maivananh111/PCB_GatewayPlus_V1.4/GatewayPlus_V1.4.kicad_pcb

## KiCad design GatewayPlus_V1.4.kicad_pcb (2023-03-02)

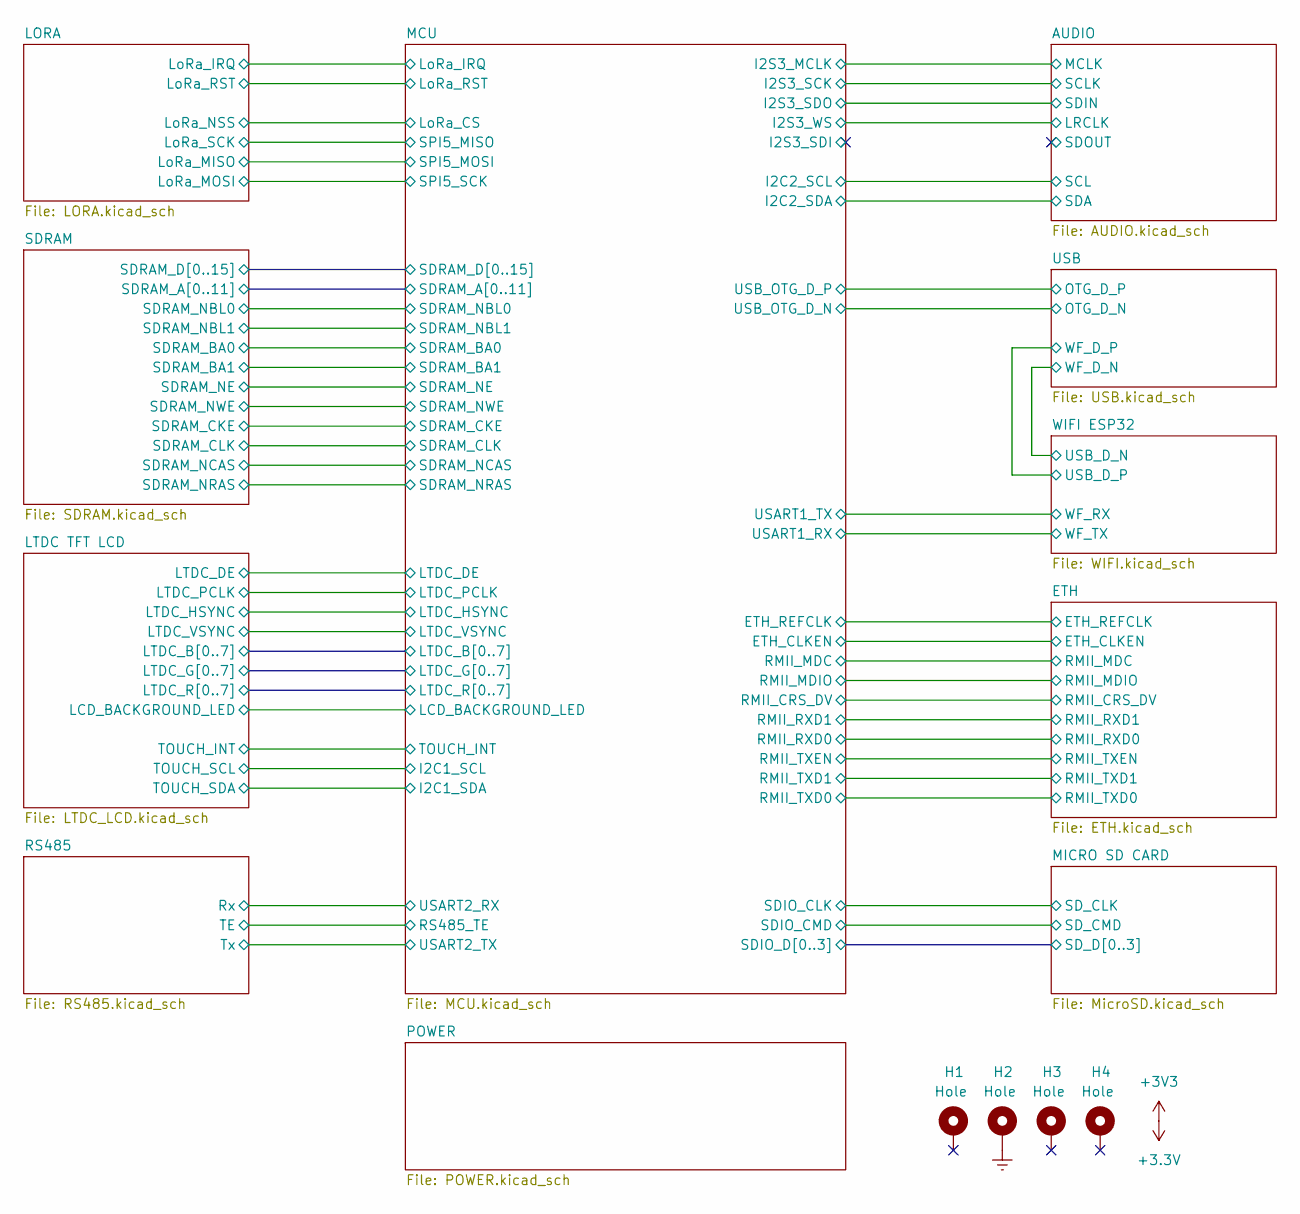
[picture p1: schematic GatewayPlus_V1.4.kicad_sch]

Parts:
H1, H2, H3, H4: Hole; MountingHole_3.2mm_M3_Pad_Via

Connections:
Earth: H2.1; also elsewhere on the board

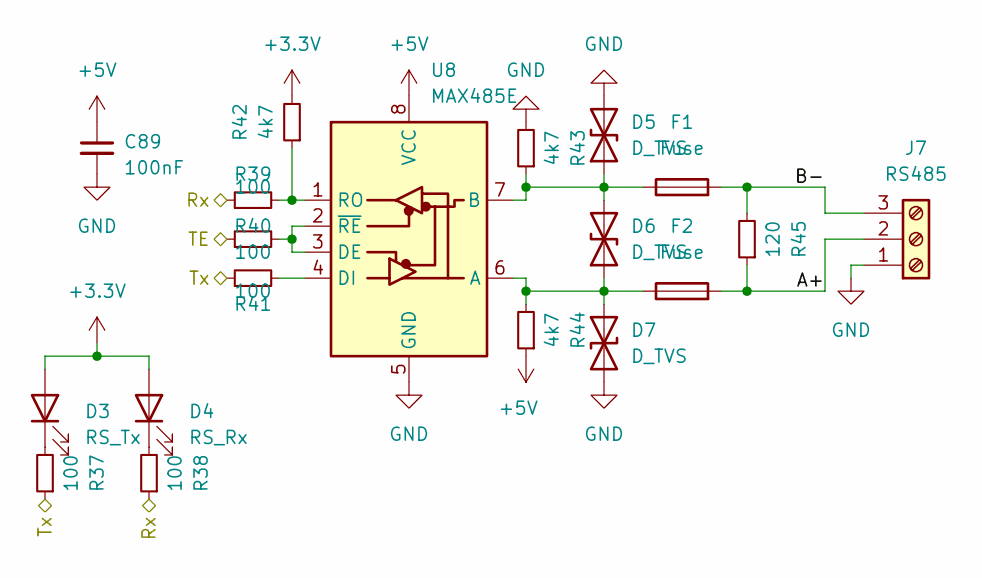
[picture p2: schematic RS485.kicad_sch]

Parts:
C89: 100nF; C_0603
D3: RS_Tx; LED_0603
D4: RS_Rx; LED_0603
D5, D6, D7: D_TVS; D_SMA
F1, F2: Fuse; F_1206
J7: RS485; TerminalBlock_Phoenix_MKDS-1,5-3-5.08_1x03_P5.08mm_Horizont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
R37, R38, R39, R40, R41: 100; R_0603
R42, R43, R44: 4k7; R_0603
R45: 120; R_0805
U8: MAX485E; SOIC-8

Connections:
/MCU/RS485_TE: R40.1; also elsewhere on the board
/MCU/USART2_RX: R38.1, R39.1; also elsewhere on the board
/MCU/USART2_TX: R37.1, R41.1; also elsewhere on the board
/RS485/A+: F2.2, J7.2, R45.1
/RS485/B-: F1.2, J7.3, R45.2
GND: C89.2, D5.2 (A2), D7.2 (A2), J7.1, R43.2, U8.5 (GND); also elsewhere on the board
unnamed: D3.1 (K), R37.2
unnamed: D4.1 (K), R38.2
unnamed: D5.1 (A1), D6.2 (A2), F1.1, R43.1, U8.7 (B)
unnamed: D6.1 (A1), D7.1 (A1), F2.1, R44.2, U8.6 (A)
unnamed: R40.2, U8.2 (~RE), U8.3 (DE)
unnamed: R41.2, U8.4 (DI)
unnamed: R39.2, R42.1, U8.1 (RO)

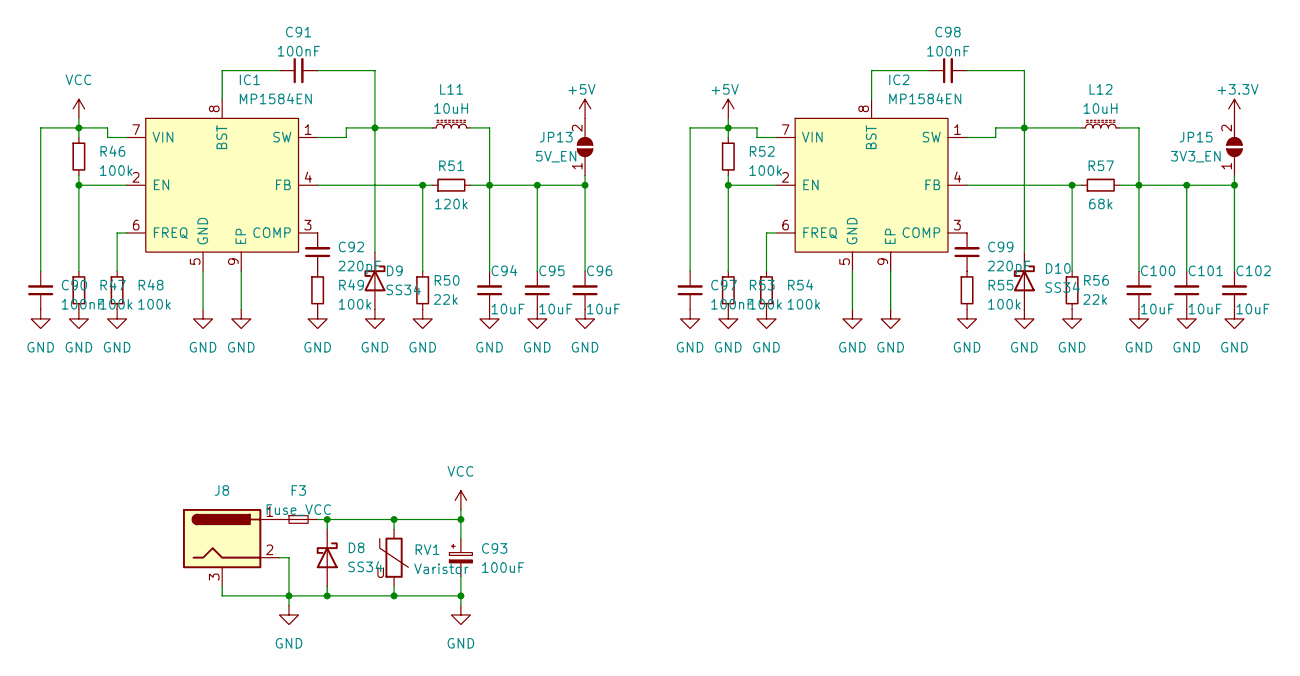
[picture p3: schematic POWER.kicad_sch]

Parts:
C90, C91, C97, C98: 100nF; C_0603
C92, C99: 220pF; C_0603
C93: 100uF; CP_Elec_6.3x5.4
C94, C95, C96, C100, C101, C102: 10uF; C_1210
D8, D9, D10: SS34; D_SMA
F3: Fuse_VCC; F_1206
IC1, IC2: MP1584EN; SOIC-8_PAD_VIAS
J8: Conn_Jack-DC; DC_PowerJack_5mm_THT
JP13: 5V_EN; SolderJumper-2_P1.3mm_Open_RoundedPad1.0x1.5mm
JP15: 3V3_EN; SolderJumper-2_P1.3mm_Open_RoundedPad1.0x1.5mm
L11, L12: 10uH; L_Abracon_ASPI-0630LR
R46, R47, R48, R49, R52, R53, R54, R55: 100k; R_0603
R50, R56: 22k; R_0603
R51: 120k; R_0603
R57: 68k; R_0603
RV1: Varistor; RV_Disc_D9mm_W3.3mm_P5mm

Connections:
GND: C90.1, C93.2, C94.1, C95.1, C96.1, C97.1, C100.1, C101.1, C102.1, D8.2 (A), D9.2 (A), D10.2 (A), IC1.5 (GND), IC1.9 (EP), IC2.5 (GND), IC2.9 (EP), J8.2, J8.3, R47.2, R48.2, R49.2, R50.2, R53.2, R54.2, R55.2, R56.2, RV1.2; also elsewhere on the board
unnamed: C92.1, R49.1
unnamed: C99.1, R55.1
unnamed: C91.2, D9.1 (K), IC1.1 (SW), L11.1
unnamed: C98.2, D10.1 (K), IC2.1 (SW), L12.1
unnamed: F3.1, J8.1
unnamed: C91.1, IC1.8 (BST)
unnamed: C92.2, IC1.3 (COMP)
unnamed: IC1.2 (EN), R46.2, R47.1
unnamed: IC1.4 (FB), R50.1, R51.1
unnamed: IC1.6 (FREQ), R48.1
unnamed: C98.1, IC2.8 (BST)
unnamed: C99.2, IC2.3 (COMP)
unnamed: IC2.2 (EN), R52.2, R53.1
unnamed: IC2.4 (FB), R56.1, R57.1
unnamed: IC2.6 (FREQ), R54.1
unnamed: C94.2, C95.2, C96.2, JP13.1 (A), L11.2, R51.2
unnamed: C100.2, C101.2, C102.2, JP15.1 (A), L12.2, R57.2
VCC: C90.2, C93.1, D8.1 (K), F3.2, IC1.7 (VIN), R46.1, RV1.1

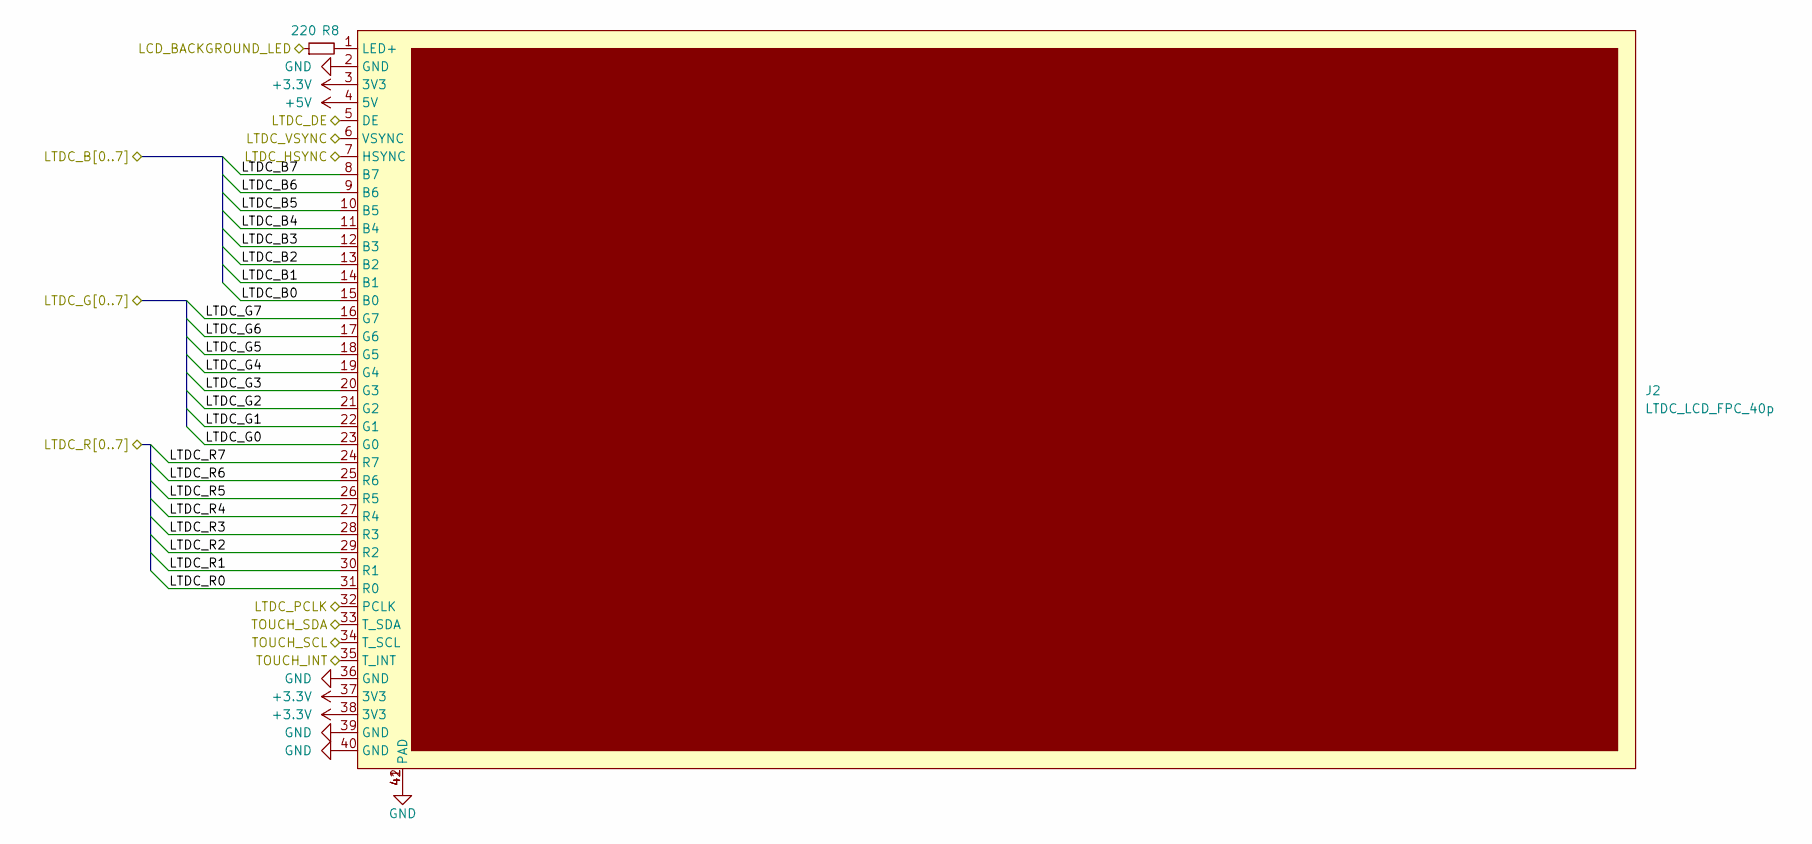
[picture p4: schematic LTDC_LCD.kicad_sch]

Parts:
J2: LTDC_LCD_FPC_40p; FPC_40p_Vertical
R8: 220; R_0603

Connections:
/LTDC TFT LCD/LCD_BACKGROUND_LED: R8.1; also elsewhere on the board
/LTDC TFT LCD/LTDC_B0: J2.15 (B0); also elsewhere on the board
/LTDC TFT LCD/LTDC_B1: J2.14 (B1); also elsewhere on the board
/LTDC TFT LCD/LTDC_B2: J2.13 (B2); also elsewhere on the board
/LTDC TFT LCD/LTDC_B3: J2.12 (B3); also elsewhere on the board
/LTDC TFT LCD/LTDC_B4: J2.11 (B4); also elsewhere on the board
/LTDC TFT LCD/LTDC_B5: J2.10 (B5); also elsewhere on the board
/LTDC TFT LCD/LTDC_B6: J2.9 (B6); also elsewhere on the board
/LTDC TFT LCD/LTDC_B7: J2.8 (B7); also elsewhere on the board
/LTDC TFT LCD/LTDC_DE: J2.5 (DE); also elsewhere on the board
/LTDC TFT LCD/LTDC_G0: J2.23 (G0); also elsewhere on the board
/LTDC TFT LCD/LTDC_G1: J2.22 (G1); also elsewhere on the board
/LTDC TFT LCD/LTDC_G2: J2.21 (G2); also elsewhere on the board
/LTDC TFT LCD/LTDC_G3: J2.20 (G3); also elsewhere on the board
/LTDC TFT LCD/LTDC_G4: J2.19 (G4); also elsewhere on the board
/LTDC TFT LCD/LTDC_G5: J2.18 (G5); also elsewhere on the board
/LTDC TFT LCD/LTDC_G6: J2.17 (G6); also elsewhere on the board
/LTDC TFT LCD/LTDC_G7: J2.16 (G7); also elsewhere on the board
/LTDC TFT LCD/LTDC_HSYNC: J2.7 (HSYNC); also elsewhere on the board
/LTDC TFT LCD/LTDC_PCLK: J2.32 (PCLK); also elsewhere on the board
/LTDC TFT LCD/LTDC_R0: J2.31 (R0); also elsewhere on the board
/LTDC TFT LCD/LTDC_R1: J2.30 (R1); also elsewhere on the board
/LTDC TFT LCD/LTDC_R2: J2.29 (R2); also elsewhere on the board
/LTDC TFT LCD/LTDC_R3: J2.28 (R3); also elsewhere on the board
/LTDC TFT LCD/LTDC_R4: J2.27 (R4); also elsewhere on the board
/LTDC TFT LCD/LTDC_R5: J2.26 (R5); also elsewhere on the board
/LTDC TFT LCD/LTDC_R6: J2.25 (R6); also elsewhere on the board
/LTDC TFT LCD/LTDC_R7: J2.24 (R7); also elsewhere on the board
/LTDC TFT LCD/LTDC_VSYNC: J2.6 (VSYNC); also elsewhere on the board
/LTDC TFT LCD/TOUCH_INT: J2.35 (T_INT); also elsewhere on the board
/LTDC TFT LCD/TOUCH_SCL: J2.34 (T_SCL); also elsewhere on the board
/LTDC TFT LCD/TOUCH_SDA: J2.33 (T_SDA); also elsewhere on the board
GND: J2.2 (GND), J2.36 (GND), J2.39 (GND), J2.40 (GND), J2.41 (PAD), J2.42 (PAD); also elsewhere on the board
unnamed: J2.1 (LED+), R8.2

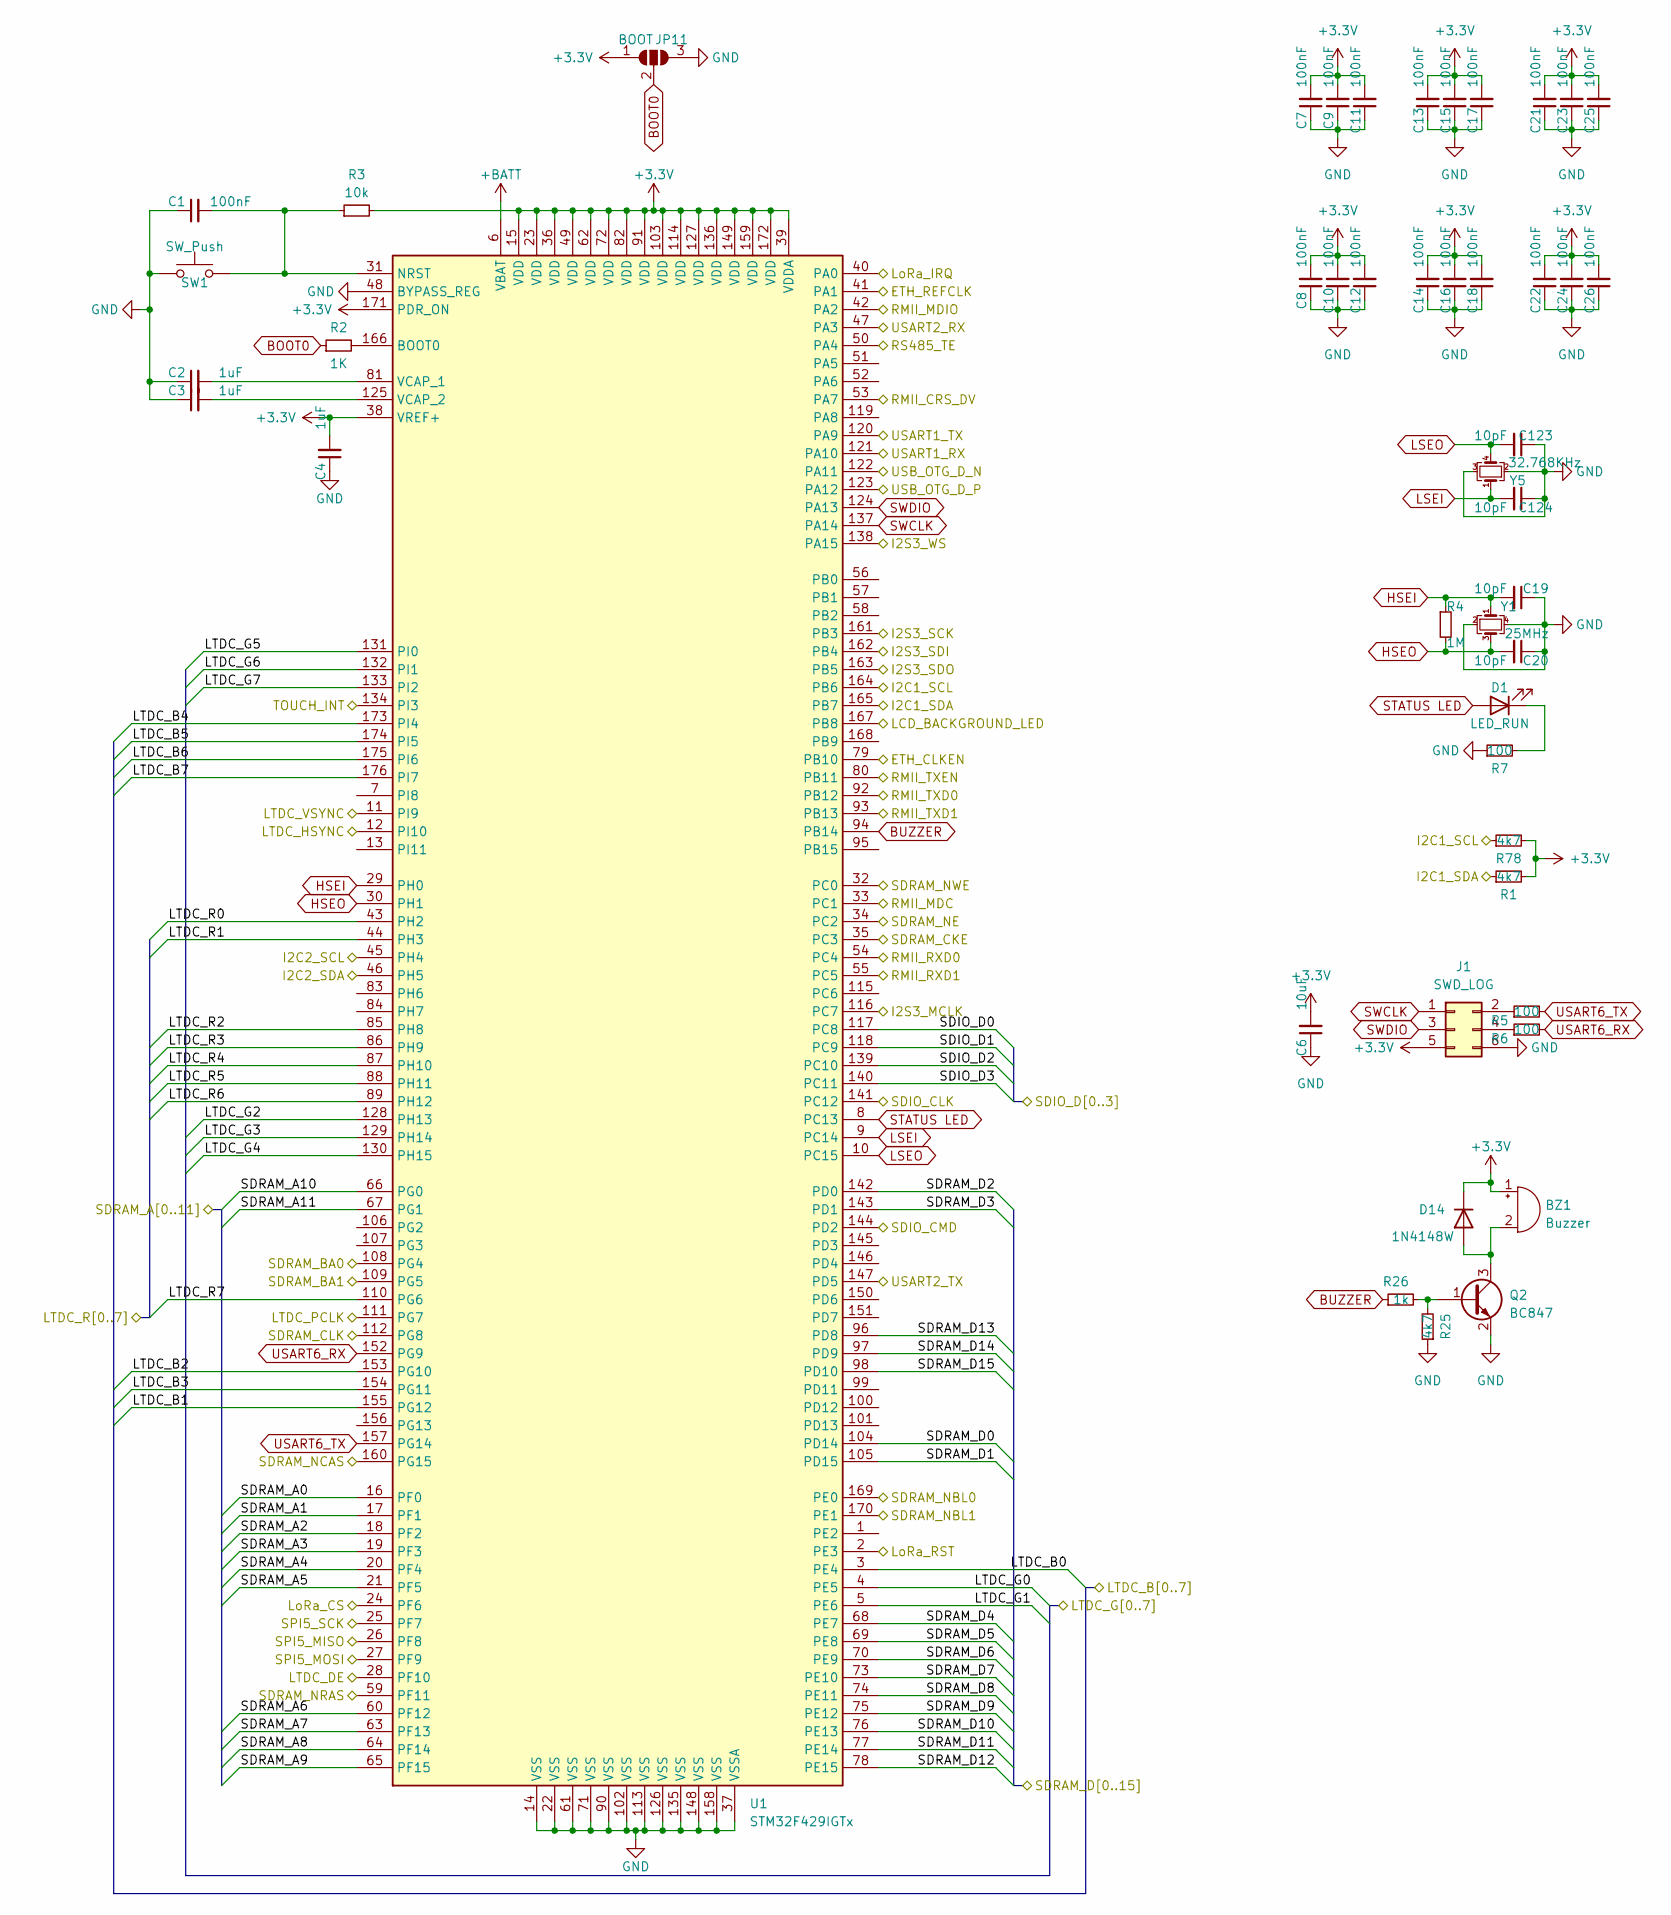
[picture p5: schematic MCU.kicad_sch]

Parts:
BZ1: Buzzer; MagneticBuzzer_ProSignal_ABT-410-RC
C1, C7, C8, C9, C10, C11, C12, C13, C14, C15, C16, C17, C18, C21, C22, C23, C24, C25, C26: 100nF; C_0603
C2, C3, C4: 1uF; C_0603
C6: 10uF; C_1206
C19, C20, C123, C124: 10pF; C_0603
D1: LED_RUN; LED_0603
D14: 1N4148W; D_SOD-123F
J1: SWD_LOG; PinHeader_2x03_P2.54mm_Horizontal
JP11: BOOT; Jump3_0603_Open
Q2: BC847; SOT23-3
R1, R25, R78: 4k7; R_0603
R2: 1K; R_0603
R3: 10k; R_0603
R4: 1M; R_0603
R5, R6, R7: 100; R_0603
R26: 1k; R_0603
SW1: SW_Push; SW_SPST_CK_RS282G05A3
U1: STM32F429IGTx; LQFP-176_24x24
Y1: 25MHz; Crystal_SMD_3225-4Pin_3.2x2.5mm
Y5: 32.768KHz; MC306327680KE3ROHS

Connections:
+BATT: U1.6 (VBAT)
/AUDIO/LRCLK: U1.138 (PA15); also elsewhere on the board
/AUDIO/MCLK: U1.116 (PC7); also elsewhere on the board
/AUDIO/SCL: U1.45 (PH4); also elsewhere on the board
/AUDIO/SCLK: U1.161 (PB3); also elsewhere on the board
/AUDIO/SDA: U1.46 (PH5); also elsewhere on the board
/AUDIO/SDIN: U1.163 (PB5); also elsewhere on the board
/ETH/ETH_REFCLK: U1.41 (PA1); also elsewhere on the board
/ETH/RMII_CRS_DV: U1.53 (PA7); also elsewhere on the board
/ETH/RMII_MDC: U1.33 (PC1); also elsewhere on the board
/ETH/RMII_MDIO: U1.42 (PA2); also elsewhere on the board
/ETH/RMII_RXD0: U1.54 (PC4); also elsewhere on the board
/ETH/RMII_RXD1: U1.55 (PC5); also elsewhere on the board
/ETH/RMII_TXD0: U1.92 (PB12); also elsewhere on the board
/ETH/RMII_TXD1: U1.93 (PB13); also elsewhere on the board
/ETH/RMII_TXEN: U1.80 (PB11); also elsewhere on the board
/LORA/LoRa_IRQ: U1.40 (PA0); also elsewhere on the board
/LORA/LoRa_MISO: U1.27 (PF9); also elsewhere on the board
/LORA/LoRa_MOSI: U1.25 (PF7); also elsewhere on the board
/LORA/LoRa_NSS: U1.24 (PF6); also elsewhere on the board
/LORA/LoRa_RST: U1.2 (PE3); also elsewhere on the board
/LORA/LoRa_SCK: U1.26 (PF8); also elsewhere on the board
/LTDC TFT LCD/LCD_BACKGROUND_LED: U1.167 (PB8); also elsewhere on the board
/LTDC TFT LCD/LTDC_B0: U1.3 (PE4); also elsewhere on the board
/LTDC TFT LCD/LTDC_B1: U1.155 (PG12); also elsewhere on the board
/LTDC TFT LCD/LTDC_B2: U1.153 (PG10); also elsewhere on the board
/LTDC TFT LCD/LTDC_B3: U1.154 (PG11); also elsewhere on the board
/LTDC TFT LCD/LTDC_B4: U1.173 (PI4); also elsewhere on the board
/LTDC TFT LCD/LTDC_B5: U1.174 (PI5); also elsewhere on the board
/LTDC TFT LCD/LTDC_B6: U1.175 (PI6); also elsewhere on the board
/LTDC TFT LCD/LTDC_B7: U1.176 (PI7); also elsewhere on the board
/LTDC TFT LCD/LTDC_DE: U1.28 (PF10); also elsewhere on the board
/LTDC TFT LCD/LTDC_G0: U1.4 (PE5); also elsewhere on the board
/LTDC TFT LCD/LTDC_G1: U1.5 (PE6); also elsewhere on the board
/LTDC TFT LCD/LTDC_G2: U1.128 (PH13); also elsewhere on the board
/LTDC TFT LCD/LTDC_G3: U1.129 (PH14); also elsewhere on the board
/LTDC TFT LCD/LTDC_G4: U1.130 (PH15); also elsewhere on the board
/LTDC TFT LCD/LTDC_G5: U1.131 (PI0); also elsewhere on the board
/LTDC TFT LCD/LTDC_G6: U1.132 (PI1); also elsewhere on the board
/LTDC TFT LCD/LTDC_G7: U1.133 (PI2); also elsewhere on the board
/LTDC TFT LCD/LTDC_HSYNC: U1.12 (PI10); also elsewhere on the board
/LTDC TFT LCD/LTDC_PCLK: U1.111 (PG7); also elsewhere on the board
/LTDC TFT LCD/LTDC_R0: U1.43 (PH2); also elsewhere on the board
/LTDC TFT LCD/LTDC_R1: U1.44 (PH3); also elsewhere on the board
/LTDC TFT LCD/LTDC_R2: U1.85 (PH8); also elsewhere on the board
/LTDC TFT LCD/LTDC_R3: U1.86 (PH9); also elsewhere on the board
/LTDC TFT LCD/LTDC_R4: U1.87 (PH10); also elsewhere on the board
/LTDC TFT LCD/LTDC_R5: U1.88 (PH11); also elsewhere on the board
/LTDC TFT LCD/LTDC_R6: U1.89 (PH12); also elsewhere on the board
/LTDC TFT LCD/LTDC_R7: U1.110 (PG6); also elsewhere on the board
/LTDC TFT LCD/LTDC_VSYNC: U1.11 (PI9); also elsewhere on the board
/LTDC TFT LCD/TOUCH_INT: U1.134 (PI3); also elsewhere on the board
/LTDC TFT LCD/TOUCH_SCL: R78.1, U1.164 (PB6); also elsewhere on the board
/LTDC TFT LCD/TOUCH_SDA: R1.1, U1.165 (PB7); also elsewhere on the board
/MCU/ETH_CLKEN: U1.79 (PB10)
/MCU/I2S3_SDI: U1.162 (PB4)
/MCU/RS485_TE: U1.50 (PA4); also elsewhere on the board
/MCU/SDIO_CLK: U1.141 (PC12); also elsewhere on the board
/MCU/SDIO_CMD: U1.144 (PD2); also elsewhere on the board
/MCU/SDIO_D0: U1.117 (PC8); also elsewhere on the board
/MCU/SDIO_D1: U1.118 (PC9); also elsewhere on the board
/MCU/SDIO_D2: U1.139 (PC10); also elsewhere on the board
/MCU/SDIO_D3: U1.140 (PC11); also elsewhere on the board
/MCU/SDRAM_A0: U1.16 (PF0); also elsewhere on the board
/MCU/SDRAM_A1: U1.17 (PF1); also elsewhere on the board
/MCU/SDRAM_A2: U1.18 (PF2); also elsewhere on the board
/MCU/SDRAM_A3: U1.19 (PF3); also elsewhere on the board
/MCU/SDRAM_A4: U1.20 (PF4); also elsewhere on the board
/MCU/SDRAM_A5: U1.21 (PF5); also elsewhere on the board
/MCU/SDRAM_A6: U1.60 (PF12); also elsewhere on the board
/MCU/SDRAM_A7: U1.63 (PF13); also elsewhere on the board
/MCU/SDRAM_A8: U1.64 (PF14); also elsewhere on the board
/MCU/SDRAM_A9: U1.65 (PF15); also elsewhere on the board
/MCU/SDRAM_A10: U1.66 (PG0); also elsewhere on the board
/MCU/SDRAM_A11: U1.67 (PG1); also elsewhere on the board
/MCU/SDRAM_BA0: U1.108 (PG4); also elsewhere on the board
/MCU/SDRAM_BA1: U1.109 (PG5); also elsewhere on the board
/MCU/SDRAM_CKE: U1.35 (PC3); also elsewhere on the board
/MCU/SDRAM_CLK: U1.112 (PG8); also elsewhere on the board
/MCU/SDRAM_D0: U1.104 (PD14); also elsewhere on the board
/MCU/SDRAM_D1: U1.105 (PD15); also elsewhere on the board
/MCU/SDRAM_D2: U1.142 (PD0); also elsewhere on the board
/MCU/SDRAM_D3: U1.143 (PD1); also elsewhere on the board
/MCU/SDRAM_D4: U1.68 (PE7); also elsewhere on the board
/MCU/SDRAM_D5: U1.69 (PE8); also elsewhere on the board
/MCU/SDRAM_D6: U1.70 (PE9); also elsewhere on the board
/MCU/SDRAM_D7: U1.73 (PE10); also elsewhere on the board
/MCU/SDRAM_D8: U1.74 (PE11); also elsewhere on the board
/MCU/SDRAM_D9: U1.75 (PE12); also elsewhere on the board
/MCU/SDRAM_D10: U1.76 (PE13); also elsewhere on the board
/MCU/SDRAM_D11: U1.77 (PE14); also elsewhere on the board
/MCU/SDRAM_D12: U1.78 (PE15); also elsewhere on the board
/MCU/SDRAM_D13: U1.96 (PD8); also elsewhere on the board
/MCU/SDRAM_D14: U1.97 (PD9); also elsewhere on the board
/MCU/SDRAM_D15: U1.98 (PD10); also elsewhere on the board
/MCU/SDRAM_NBL0: U1.169 (PE0); also elsewhere on the board
/MCU/SDRAM_NBL1: U1.170 (PE1); also elsewhere on the board
/MCU/SDRAM_NCAS: U1.160 (PG15); also elsewhere on the board
/MCU/SDRAM_NE: U1.34 (PC2); also elsewhere on the board
/MCU/SDRAM_NRAS: U1.59 (PF11); also elsewhere on the board
/MCU/SDRAM_NWE: U1.32 (PC0); also elsewhere on the board
/MCU/USART1_RX: U1.121 (PA10); also elsewhere on the board
/MCU/USART1_TX: U1.120 (PA9); also elsewhere on the board
/MCU/USART2_RX: U1.47 (PA3); also elsewhere on the board
/MCU/USART2_TX: U1.147 (PD5); also elsewhere on the board
/MCU/USB_OTG_D_N: U1.122 (PA11); also elsewhere on the board
/MCU/USB_OTG_D_P: U1.123 (PA12); also elsewhere on the board
BOOT0: JP11.2 (C), R2.1
BUZZER: R26.1, U1.94 (PB14)
GND: C1.1, C2.1, C3.1, C4.1, C6.1, C7.1, C8.1, C9.1, C10.1, C11.1, C12.1, C13.1, C14.1, C15.1, C16.1, C17.1, C18.1, C19.1, C20.1, C21.1, C22.1, C23.1, C24.1, C25.1, C26.1, C123.1, C124.1, J1.6, JP11.3 (B), Q2.2 (E), R7.1, R25.1, SW1.1, U1.14 (VSS), U1.22 (VSS), U1.37 (VSSA), U1.48 (BYPASS_REG), U1.61 (VSS), U1.71 (VSS), U1.90 (VSS), U1.102 (VSS), U1.113 (VSS), U1.126 (VSS), U1.135 (VSS), U1.148 (VSS), U1.158 (VSS), Y1.2, Y1.4, Y5.2, Y5.3; also elsewhere on the board
HSEI: C19.2, R4.1, U1.29 (PH0), Y1.1
HSEO: C20.2, R4.2, U1.30 (PH1), Y1.3
LSEI: C124.2, U1.9 (PC14), Y5.1
LSEO: C123.2, U1.10 (PC15), Y5.4
unnamed: BZ1.2 (+), D14.2 (A), Q2.3 (C)
unnamed: D1.1 (K), R7.2
unnamed: J1.2, R5.1
unnamed: J1.4, R6.1
unnamed: Q2.1 (B), R25.2, R26.2
unnamed: R2.2, U1.166 (BOOT0)
unnamed: C1.2, R3.1, SW1.2, U1.31 (NRST)
unnamed: C2.2, U1.81 (VCAP_1)
unnamed: C3.2, U1.125 (VCAP_2)
STATUS LED: D1.2 (A), U1.8 (PC13)
SWCLK: J1.1, U1.137 (PA14)
SWDIO: J1.3, U1.124 (PA13)
USART6_RX: R6.2, U1.152 (PG9)
USART6_TX: R5.2, U1.157 (PG14)

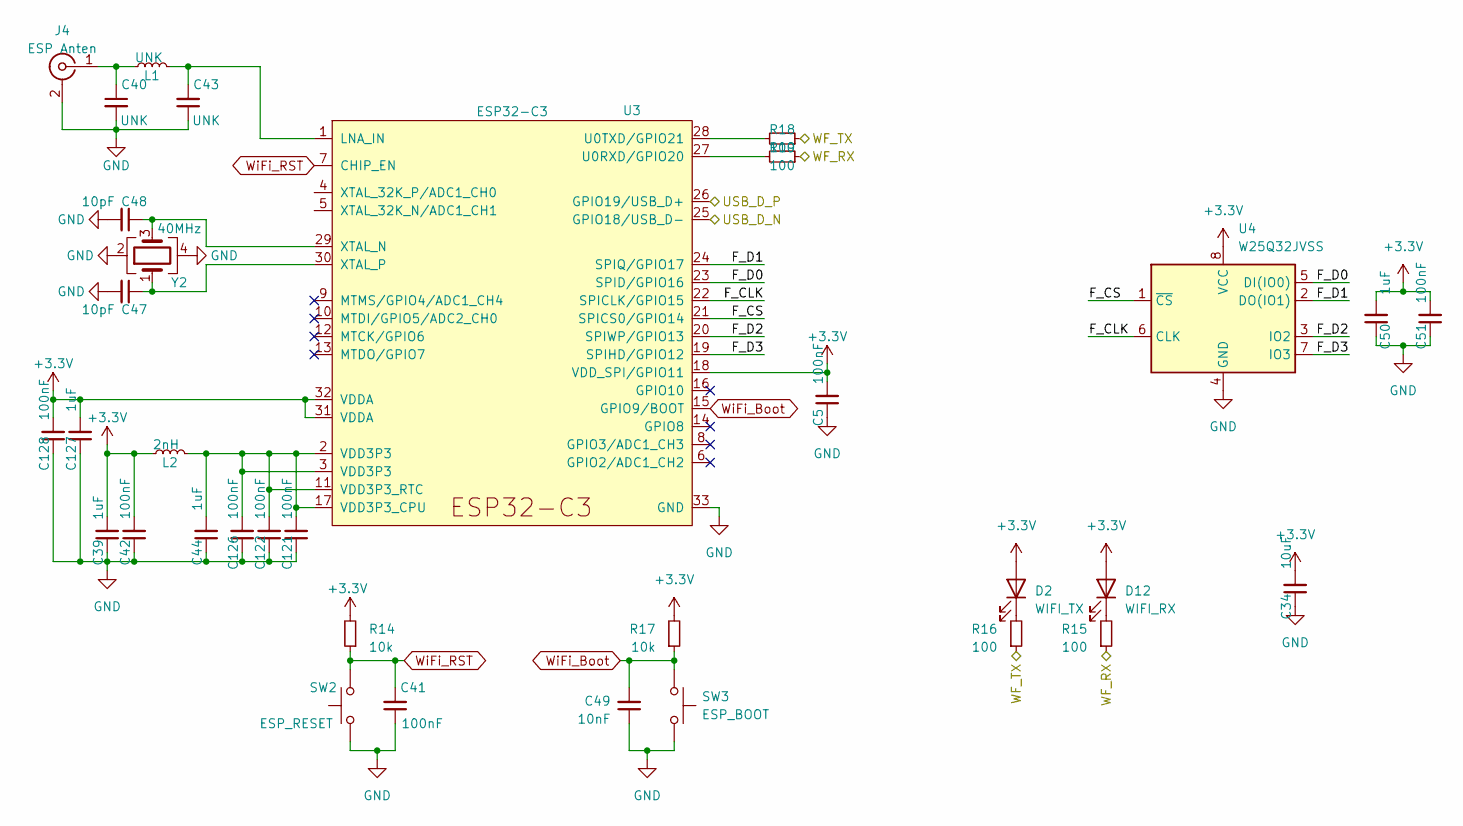
[picture p6: schematic WIFI.kicad_sch]

Parts:
C5, C41, C42, C51, C121, C122, C126, C128: 100nF; C_0603
C34: 10uF; C_1206
C39, C44, C50, C127: 1uF; C_0603
C40, C43: UNK; C_0603
C47, C48: 10pF; C_0603
C49: 10nF; C_0603
D2: WIFI_TX; LED_0603
D12: WIFI_RX; LED_0603
J4: ESP Anten; IPEX_Antena_Connector
L1: UNK; L_0603
L2: 2nH; L_0603
R14, R17: 10k; R_0603
R15, R16, R18, R19: 100; R_0603
SW2: ESP_RESET; SW_SPST_CK_RS282G05A3
SW3: ESP_BOOT; SW_SPST_CK_RS282G05A3
U3: ESP32-C3; QFN-32_5x5_PAD-VIAS
U4: W25Q32JVSS; SOIC-8_5.23x5.23
Y2: 40MHz; Crystal_SMD_3225-4Pin_3.2x2.5mm

Connections:
/MCU/USART1_RX: R16.1, R18.1; also elsewhere on the board
/MCU/USART1_TX: R15.1, R19.1; also elsewhere on the board
/USB/WF_D_N: U3.25 (GPIO18/USB_D-); also elsewhere on the board
/USB/WF_D_P: U3.26 (GPIO19/USB_D+); also elsewhere on the board
/WIFI ESP32/F_CLK: U3.22 (SPICLK/GPIO15), U4.6 (CLK)
/WIFI ESP32/F_CS: U3.21 (SPICS0/GPIO14), U4.1 (~CS)
/WIFI ESP32/F_D0: U3.23 (SPID/GPIO16), U4.5 (DI(IO0))
/WIFI ESP32/F_D1: U3.24 (SPIQ/GPIO17), U4.2 (DO(IO1))
/WIFI ESP32/F_D2: U3.20 (SPIWP/GPIO13), U4.3 (IO2)
/WIFI ESP32/F_D3: U3.19 (SPIHD/GPIO12), U4.7 (IO3)
GND: C5.1, C34.1, C39.1, C40.2, C41.1, C42.1, C43.1, C44.1, C47.2, C48.2, C49.1, C50.1, C51.1, C121.1, C122.1, C126.1, C127.1, C128.1, J4.2 (Ext), SW2.1, SW3.1, U3.33 (GND), U4.4 (GND), Y2.2, Y2.4; also elsewhere on the board
unnamed: D2.1 (K), R16.2
unnamed: D12.1 (K), R15.2
unnamed: C40.1, J4.1 (In), L1.1
unnamed: C43.2, L1.2, U3.1 (LNA_IN)
unnamed: R19.2, U3.27 (U0RXD/GPIO20)
unnamed: R18.2, U3.28 (U0TXD/GPIO21)
unnamed: C44.2, C121.2, C122.2, C126.2, L2.2, U3.2 (VDD3P3), U3.3 (VDD3P3), U3.11 (VDD3P3_RTC), U3.17 (VDD3P3_CPU)
unnamed: C48.1, U3.29 (XTAL_N), Y2.3
unnamed: C47.1, U3.30 (XTAL_P), Y2.1
WiFi_Boot: C49.2, R17.1, SW3.2, U3.15 (GPIO9/BOOT)
WiFi_RST: C41.2, R14.1, SW2.2, U3.7 (CHIP_EN)

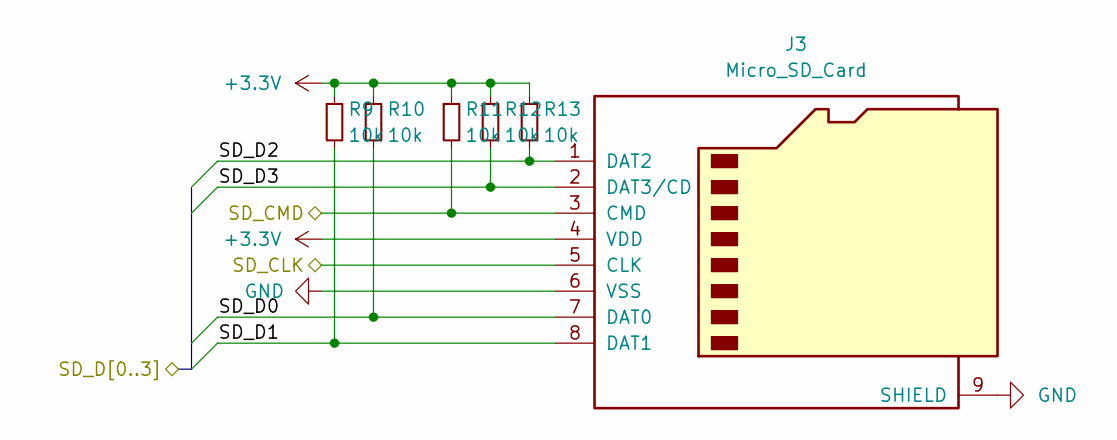
[picture p7: schematic MicroSD.kicad_sch]

Parts:
J3: Micro_SD_Card; MicroSD_Socket
R9, R10, R11, R12, R13: 10k; R_0603

Connections:
/MCU/SDIO_CLK: J3.5 (CLK); also elsewhere on the board
/MCU/SDIO_CMD: J3.3 (CMD), R11.2; also elsewhere on the board
/MCU/SDIO_D0: J3.7 (DAT0), R10.2; also elsewhere on the board
/MCU/SDIO_D1: J3.8 (DAT1), R9.2; also elsewhere on the board
/MCU/SDIO_D2: J3.1 (DAT2), R13.2; also elsewhere on the board
/MCU/SDIO_D3: J3.2 (DAT3/CD), R12.2; also elsewhere on the board
GND: J3.6 (VSS), J3.9 (SHIELD); also elsewhere on the board

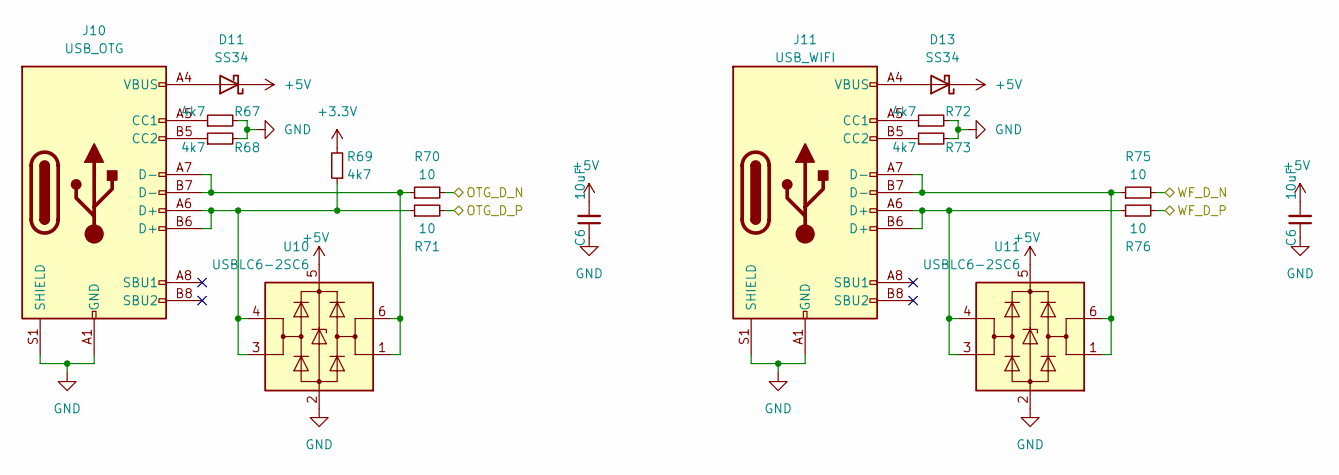
[picture p8: schematic USB.kicad_sch]

Parts:
C6: 10uF; C_1206
D11, D13: SS34; D_SMA
J10: USB_OTG; USB-C_SMD_1
J11: USB_WIFI; USB-C_SMD_1
R67, R68, R69, R72, R73: 4k7; R_0603
R70, R71, R75, R76: 10; R_0603
U10, U11: USBLC6-2SC6; SOT23-6

Connections:
/MCU/USB_OTG_D_N: R70.2; also elsewhere on the board
/MCU/USB_OTG_D_P: R71.2; also elsewhere on the board
/USB/WF_D_N: R75.2; also elsewhere on the board
/USB/WF_D_P: R76.2; also elsewhere on the board
GND: C6.1, J10.A1 (GND), J10.A12 (GND), J10.B1 (GND), J10.B12 (GND), J10.S1 (SHIELD), J11.A1 (GND), J11.A12 (GND), J11.B1 (GND), J11.B12 (GND), J11.S1 (SHIELD), R67.2, R68.2, R72.2, R73.2, U10.2 (GND), U11.2 (GND); also elsewhere on the board
unnamed: D11.2 (A), J10.A4 (VBUS), J10.A9 (VBUS), J10.B4 (VBUS), J10.B9 (VBUS)
unnamed: D13.2 (A), J11.A4 (VBUS), J11.A9 (VBUS), J11.B4 (VBUS), J11.B9 (VBUS)
unnamed: J10.A5 (CC1), R67.1
unnamed: J10.B5 (CC2), R68.1
unnamed: J10.A6 (D+), J10.B6 (D+), R69.1, R71.1, U10.3 (I/O2), U10.4 (I/O2)
unnamed: J10.A7 (D-), J10.B7 (D-), R70.1, U10.1 (I/O1), U10.6 (I/O1)
unnamed: J11.A5 (CC1), R72.1
unnamed: J11.B5 (CC2), R73.1
unnamed: J11.A6 (D+), J11.B6 (D+), R76.1, U11.3 (I/O2), U11.4 (I/O2)
unnamed: J11.A7 (D-), J11.B7 (D-), R75.1, U11.1 (I/O1), U11.6 (I/O1)

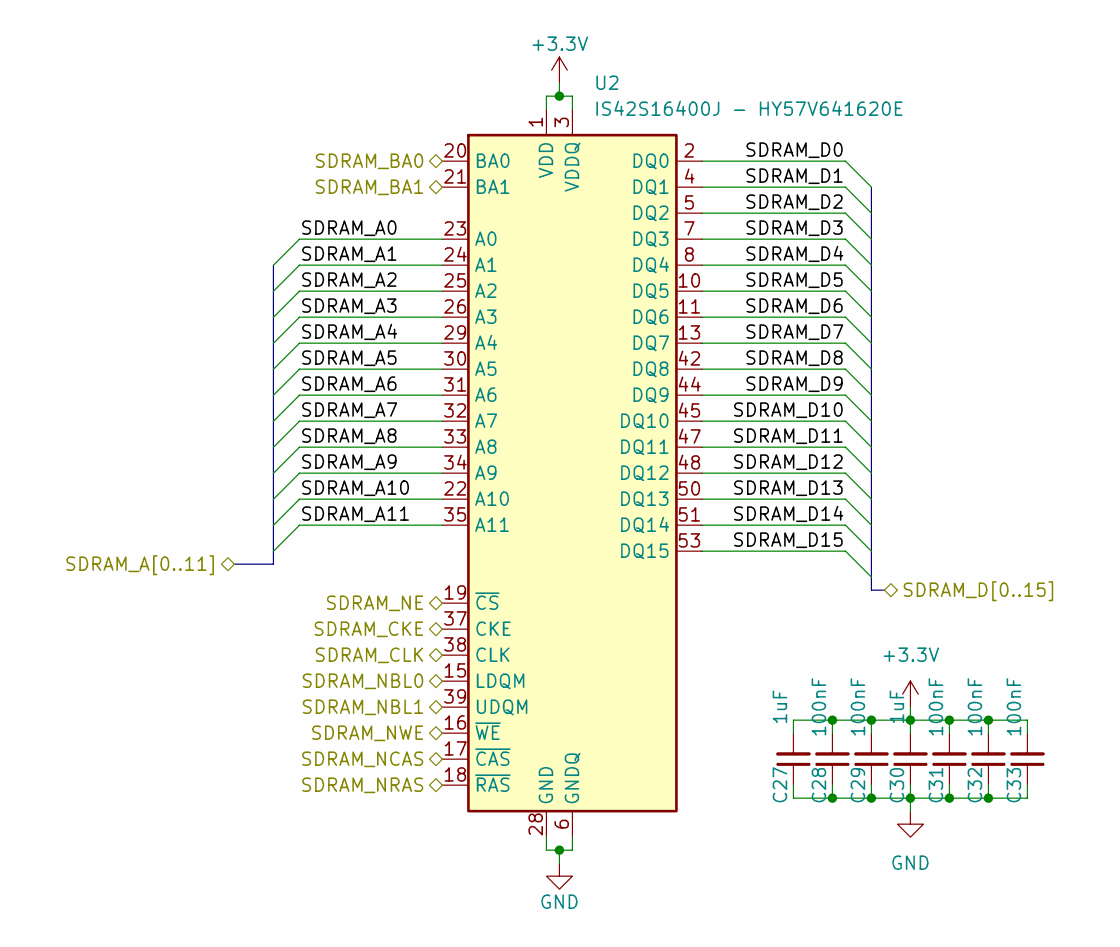
[picture p9: schematic SDRAM.kicad_sch]

Parts:
C27, C30: 1uF; C_0603
C28, C29, C31, C32, C33: 100nF; C_0603
U2: IS42S16400J - HY57V641620E; TSOP-II-54_22.2x10.16

Connections:
/MCU/SDRAM_A0: U2.23 (A0); also elsewhere on the board
/MCU/SDRAM_A1: U2.24 (A1); also elsewhere on the board
/MCU/SDRAM_A2: U2.25 (A2); also elsewhere on the board
/MCU/SDRAM_A3: U2.26 (A3); also elsewhere on the board
/MCU/SDRAM_A4: U2.29 (A4); also elsewhere on the board
/MCU/SDRAM_A5: U2.30 (A5); also elsewhere on the board
/MCU/SDRAM_A6: U2.31 (A6); also elsewhere on the board
/MCU/SDRAM_A7: U2.32 (A7); also elsewhere on the board
/MCU/SDRAM_A8: U2.33 (A8); also elsewhere on the board
/MCU/SDRAM_A9: U2.34 (A9); also elsewhere on the board
/MCU/SDRAM_A10: U2.22 (A10); also elsewhere on the board
/MCU/SDRAM_A11: U2.35 (A11); also elsewhere on the board
/MCU/SDRAM_BA0: U2.20 (BA0); also elsewhere on the board
/MCU/SDRAM_BA1: U2.21 (BA1); also elsewhere on the board
/MCU/SDRAM_CKE: U2.37 (CKE); also elsewhere on the board
/MCU/SDRAM_CLK: U2.38 (CLK); also elsewhere on the board
/MCU/SDRAM_D0: U2.2 (DQ0); also elsewhere on the board
/MCU/SDRAM_D1: U2.4 (DQ1); also elsewhere on the board
/MCU/SDRAM_D2: U2.5 (DQ2); also elsewhere on the board
/MCU/SDRAM_D3: U2.7 (DQ3); also elsewhere on the board
/MCU/SDRAM_D4: U2.8 (DQ4); also elsewhere on the board
/MCU/SDRAM_D5: U2.10 (DQ5); also elsewhere on the board
/MCU/SDRAM_D6: U2.11 (DQ6); also elsewhere on the board
/MCU/SDRAM_D7: U2.13 (DQ7); also elsewhere on the board
/MCU/SDRAM_D8: U2.42 (DQ8); also elsewhere on the board
/MCU/SDRAM_D9: U2.44 (DQ9); also elsewhere on the board
/MCU/SDRAM_D10: U2.45 (DQ10); also elsewhere on the board
/MCU/SDRAM_D11: U2.47 (DQ11); also elsewhere on the board
/MCU/SDRAM_D12: U2.48 (DQ12); also elsewhere on the board
/MCU/SDRAM_D13: U2.50 (DQ13); also elsewhere on the board
/MCU/SDRAM_D14: U2.51 (DQ14); also elsewhere on the board
/MCU/SDRAM_D15: U2.53 (DQ15); also elsewhere on the board
/MCU/SDRAM_NBL0: U2.15 (LDQM); also elsewhere on the board
/MCU/SDRAM_NBL1: U2.39 (UDQM); also elsewhere on the board
/MCU/SDRAM_NCAS: U2.17 (~CAS); also elsewhere on the board
/MCU/SDRAM_NE: U2.19 (~CS); also elsewhere on the board
/MCU/SDRAM_NRAS: U2.18 (~RAS); also elsewhere on the board
/MCU/SDRAM_NWE: U2.16 (~WE); also elsewhere on the board
GND: C27.1, C28.1, C29.1, C30.1, C31.1, C32.1, C33.1, U2.6 (GNDQ), U2.12 (GNDQ), U2.28 (GND), U2.41 (GND), U2.46 (GNDQ), U2.52 (GNDQ), U2.54 (GND); also elsewhere on the board
