maivananh111/PCB_GatewayPlus_V1.4/GatewayPlus_V1.4.kicad_pcb

## KiCad design GatewayPlus_V1.4.kicad_pcb (continued)

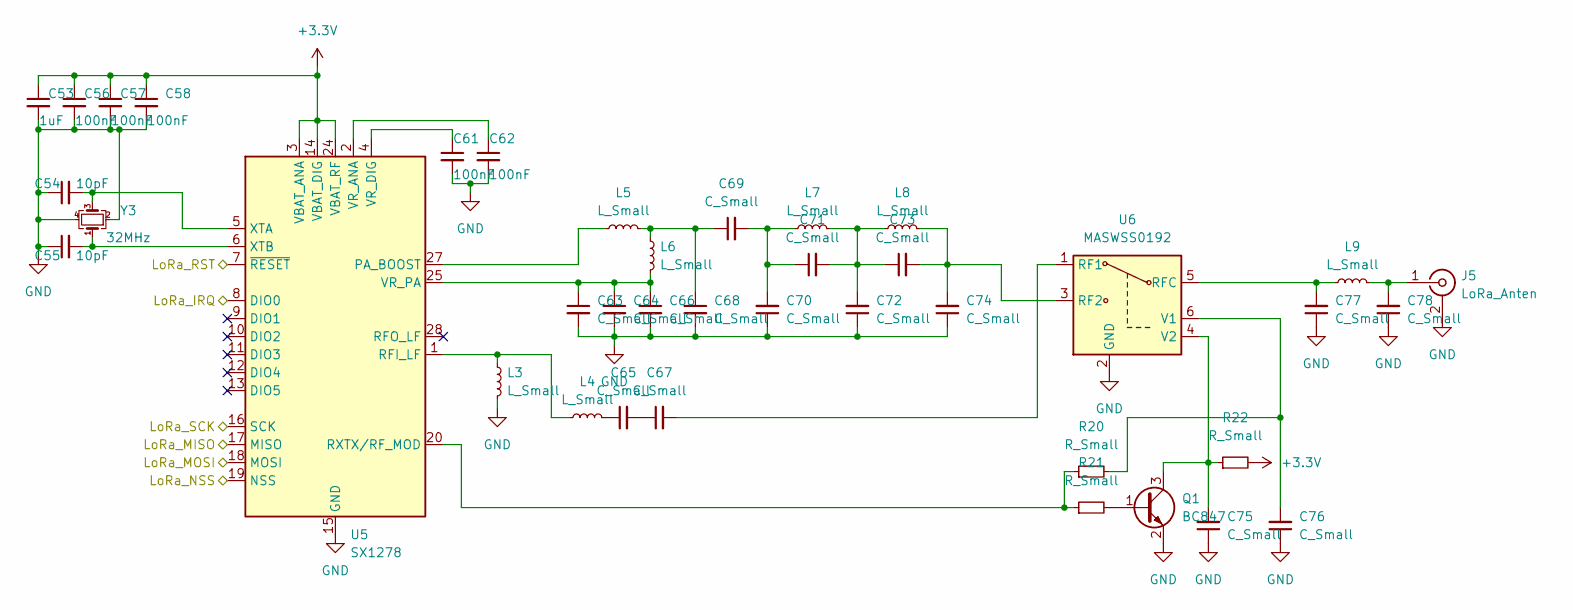
[picture p10: schematic LORA.kicad_sch]

Parts:
C53: 1uF; C_0603
C54, C55: 10pF; C_0603
C56, C57, C58, C61, C62: 100nF; C_0603
C63, C64, C65, C66, C67, C68, C69, C70, C71, C72, C73, C74, C75, C76, C77, C78: C_Small; C_0603
J5: LoRa_Anten; IPEX_Antena_Connector
L3, L4, L5, L6, L7, L8, L9: L_Small; L_0603
Q1: BC847; SOT23-3
R20, R21, R22: R_Small; R_0603
U5: SX1278; QFN-28_6x6_PAD
U6: MASWSS0192; SOT-363_SC-70-6
Y3: 32MHz; Crystal_SMD_3225-4Pin_3.2x2.5mm

Connections:
/LORA/LoRa_IRQ: U5.8 (DIO0); also elsewhere on the board
/LORA/LoRa_MISO: U5.17 (MISO); also elsewhere on the board
/LORA/LoRa_MOSI: U5.18 (MOSI); also elsewhere on the board
/LORA/LoRa_NSS: U5.19 (NSS); also elsewhere on the board
/LORA/LoRa_RST: U5.7 (~RESET); also elsewhere on the board
/LORA/LoRa_SCK: U5.16 (SCK); also elsewhere on the board
GND: C53.2, C54.1, C55.1, C56.2, C57.2, C58.2, C61.2, C62.2, C63.2, C64.2, C66.2, C68.2, C70.1, C72.1, C74.1, C75.1, C76.1, C77.1, C78.1, J5.2 (Ext), L3.2, Q1.2 (E), U5.15 (GND), U5.21 (GND), U5.22 (GND), U5.23 (GND), U5.26 (GND), U5.29 (GND), U6.2 (GND), Y3.2, Y3.4; also elsewhere on the board
unnamed: C65.1, L4.2
unnamed: C65.2, C67.1
unnamed: C68.1, C69.1, L5.2, L6.1
unnamed: C69.2, C70.2, C71.1, L7.1
unnamed: C71.2, C72.2, C73.1, L7.2, L8.1
unnamed: C78.2, J5.1 (In), L9.2
unnamed: Q1.1 (B), R21.2
unnamed: C75.2, Q1.3 (C), R22.1, U6.4 (V2)
unnamed: L5.1, U5.27 (PA_BOOST)
unnamed: L3.1, L4.1, U5.1 (RFI_LF)
unnamed: R20.1, R21.1, U5.20 (RXTX/RF_MOD)
unnamed: C62.1, U5.2 (VR_ANA)
unnamed: C61.1, U5.4 (VR_DIG)
unnamed: C63.1, C64.1, C66.1, L6.2, U5.25 (VR_PA)
unnamed: C54.2, U5.5 (XTA), Y3.3
unnamed: C55.2, U5.6 (XTB), Y3.1
unnamed: C67.2, U6.1 (RF1)
unnamed: C73.2, C74.2, L8.2, U6.3 (RF2)
unnamed: C77.2, L9.1, U6.5 (RFC)
unnamed: C76.2, R20.2, U6.6 (V1)

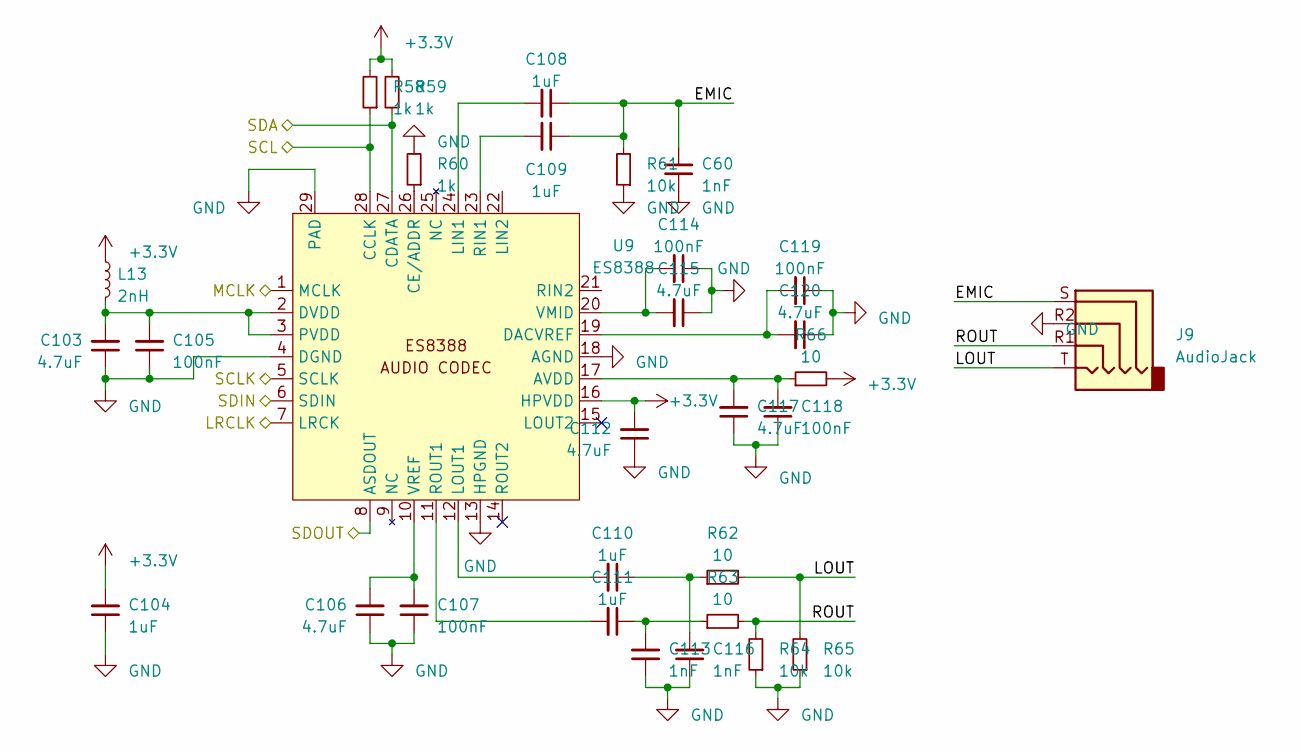
[picture p11: schematic AUDIO.kicad_sch]

Parts:
C60, C113, C116: 1nF; C_0603
C103, C106, C112, C115, C117, C120: 4.7uF; C_0603
C104, C108, C109, C110, C111: 1uF; C_0603
C105, C107, C114, C118, C119: 100nF; C_0603
J9: AudioJack; AudioJack_3.5mm_PJ-320A
L13: 2nH; L_0603
R58, R59, R60: 1k; R_0603
R61, R64, R65: 10k; R_0603
R62, R63, R66: 10; R_0603
U9: ES8388; QFN-28_4x4_PAD-VIAS

Connections:
/AUDIO/EMIC: C60.2, C108.1, C109.1, J9.S, R61.2
/AUDIO/LOUT: J9.T, R62.2, R65.2
/AUDIO/LRCLK: U9.7 (LRCK); also elsewhere on the board
/AUDIO/MCLK: U9.1 (MCLK); also elsewhere on the board
/AUDIO/ROUT: J9.R1, R63.2, R64.2
/AUDIO/SCL: R58.1, U9.28 (CCLK); also elsewhere on the board
/AUDIO/SCLK: U9.5 (SCLK); also elsewhere on the board
/AUDIO/SDA: R59.1, U9.27 (CDATA); also elsewhere on the board
/AUDIO/SDIN: U9.6 (SDIN); also elsewhere on the board
/AUDIO/SDOUT: U9.8 (ASDOUT)
GND: C60.1, C103.1, C104.1, C105.1, C106.1, C107.1, C112.1, C113.1, C114.1, C115.1, C116.1, C117.1, C118.1, C119.1, C120.1, J9.R2, R60.2, R61.1, R64.1, R65.1, U9.4 (DGND), U9.13 (HPGND), U9.18 (AGND), U9.29 (PAD); also elsewhere on the board
unnamed: C110.1, C116.2, R62.1
unnamed: C111.1, C113.2, R63.1
unnamed: C117.2, C118.2, R66.1, U9.17 (AVDD)
unnamed: R60.1, U9.26 (CE/ADDR)
unnamed: C119.2, C120.2, U9.19 (DACVREF)
unnamed: C103.2, C105.2, L13.2, U9.2 (DVDD), U9.3 (PVDD)
unnamed: C108.2, U9.24 (LIN1)
unnamed: C110.2, U9.12 (LOUT1)
unnamed: C109.2, U9.23 (RIN1)
unnamed: C111.2, U9.11 (ROUT1)
unnamed: C114.2, C115.2, U9.20 (VMID)
unnamed: C106.2, C107.2, U9.10 (VREF)

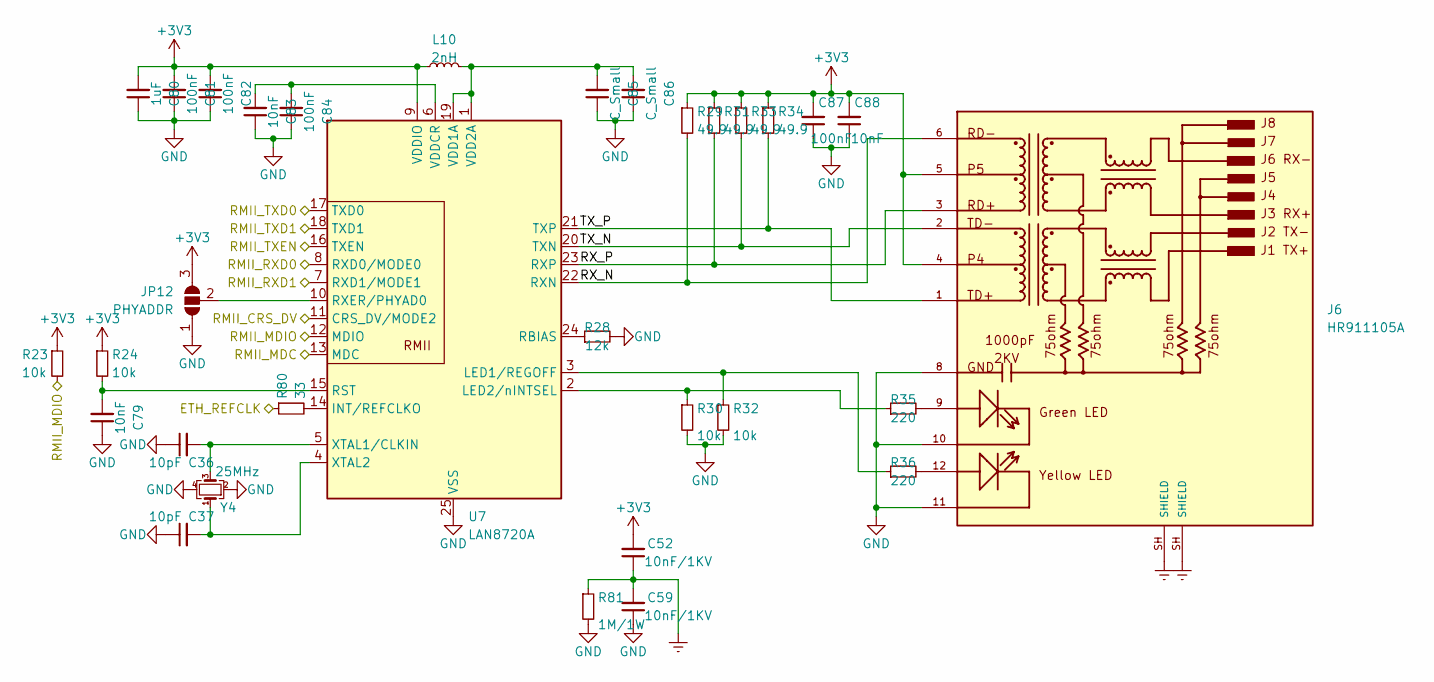
[picture p12: schematic ETH.kicad_sch]

Parts:
C36, C37: 10pF; C_0603
C52, C59: 10nF/1KV; C_1206
C79, C83, C88: 10nF; C_0603
C80: 1uF; C_0603
C81, C82, C84, C87: 100nF; C_0603
C85, C86: C_Small; C_0603
J6: HR911105A; RJ45_Hanrun_HR911105A
JP12: PHYADDR; Jump3_0603_Open
L10: 2nH; L_0603
R23, R24, R30, R32: 10k; R_0603
R28: 12k; R_0603
R29, R31, R33, R34: 49.9; R_0603
R35, R36: 220; R_0603
R80: 33; R_0603
R81: 1M/1W; R_1206
U7: LAN8720A; QFN-24_4x4mm_PAD-VIAS
Y4: 25MHz; Crystal_SMD_3225-4Pin_3.2x2.5mm

Connections:
/ETH/ETH_REFCLK: R80.1; also elsewhere on the board
/ETH/RMII_CRS_DV: U7.11 (CRS_DV/MODE2); also elsewhere on the board
/ETH/RMII_MDC: U7.13 (MDC); also elsewhere on the board
/ETH/RMII_MDIO: R23.2, U7.12 (MDIO); also elsewhere on the board
/ETH/RMII_RXD0: U7.8 (RXD0/MODE0); also elsewhere on the board
/ETH/RMII_RXD1: U7.7 (RXD1/MODE1); also elsewhere on the board
/ETH/RMII_TXD0: U7.17 (TXD0); also elsewhere on the board
/ETH/RMII_TXD1: U7.18 (TXD1); also elsewhere on the board
/ETH/RMII_TXEN: U7.16 (TXEN); also elsewhere on the board
/ETH/RX_N: J6.6, R29.2, U7.22 (RXN)
/ETH/RX_P: J6.3, R31.2, U7.23 (RXP)
/ETH/TX_N: J6.2, R33.2, U7.20 (TXN)
/ETH/TX_P: J6.1, R34.2, U7.21 (TXP)
Earth: C52.1, C59.2, J6.SH (SHIELD), R81.1; also elsewhere on the board
GND: C36.1, C37.1, C59.1, C79.1, C80.1, C81.1, C82.1, C83.1, C84.1, C85.1, C86.1, C87.1, C88.1, J6.8, J6.10, J6.11, JP12.1 (A), R28.2, R30.2, R32.2, R81.2, U7.25 (VSS), Y4.2, Y4.4; also elsewhere on the board
unnamed: J6.9, R35.2
unnamed: J6.12, R36.2
unnamed: JP12.2 (C), U7.10 (RXER/PHYAD0)
unnamed: R80.2, U7.14 (INT/REFCLKO)
unnamed: R32.1, R36.1, U7.3 (LED1/REGOFF)
unnamed: R30.1, R35.1, U7.2 (LED2/nINTSEL)
unnamed: R28.1, U7.24 (RBIAS)
unnamed: C79.2, R24.2, U7.15 (RST)
unnamed: C85.2, C86.2, L10.2, U7.1 (VDD2A), U7.19 (VDD1A)
unnamed: C83.2, C84.2, U7.6 (VDDCR)
unnamed: C36.2, U7.5 (XTAL1/CLKIN), Y4.3
unnamed: C37.2, U7.4 (XTAL2), Y4.1

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
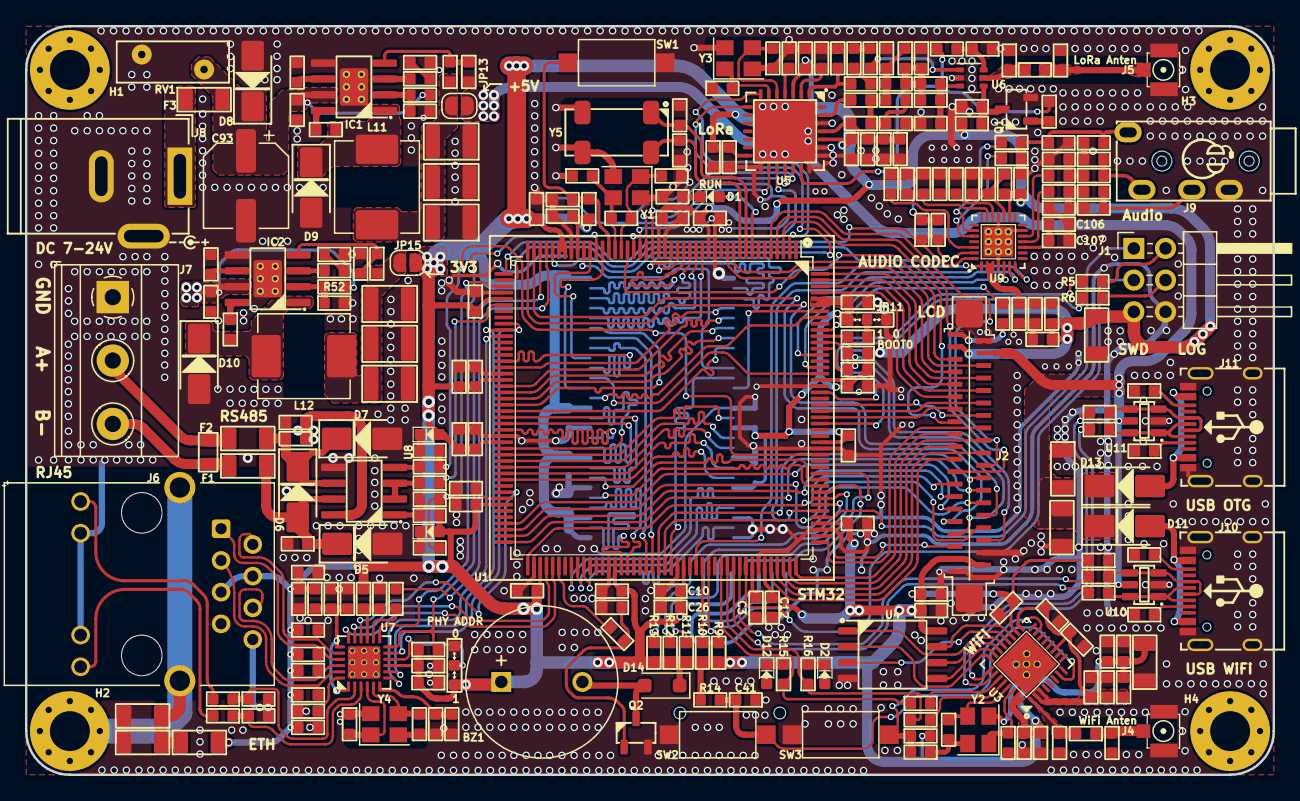
[picture p13: board GatewayPlus_V1.4.kicad_pcb from above]

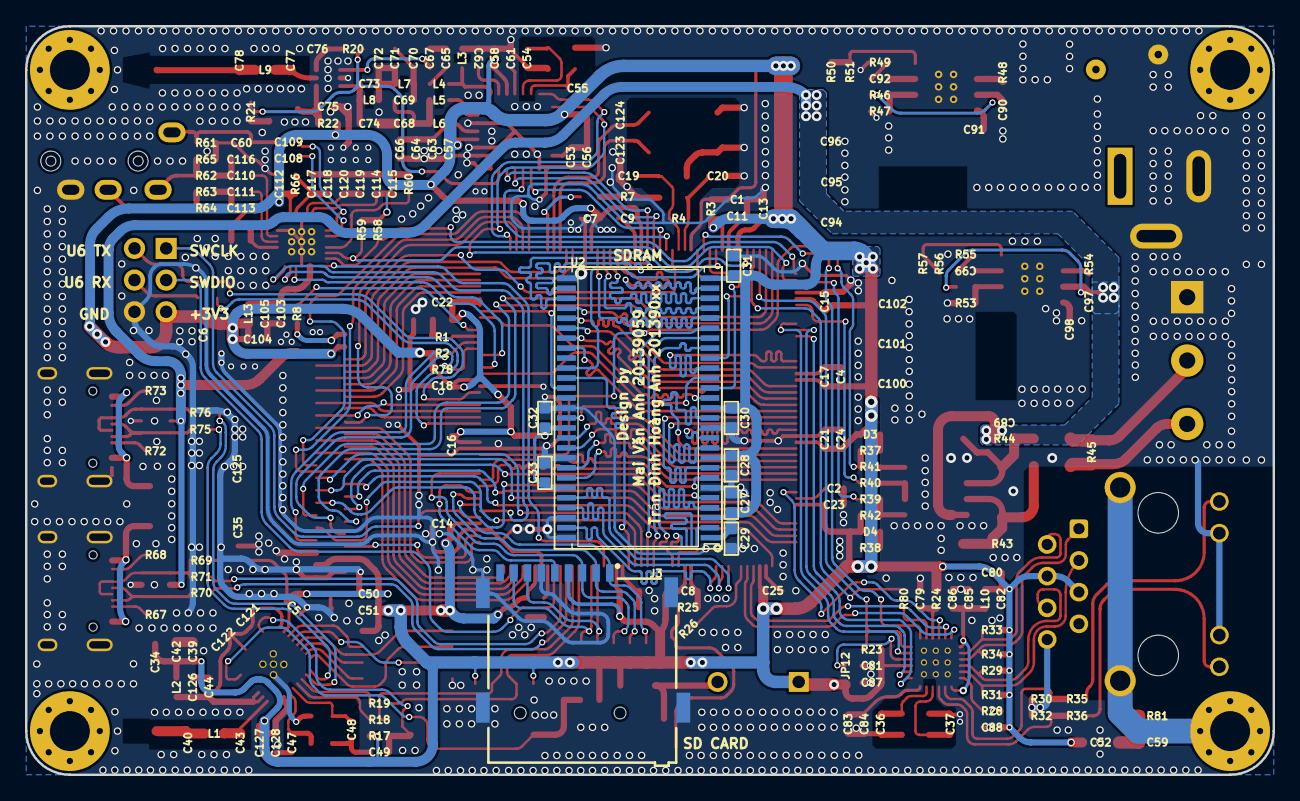
[picture p14: board GatewayPlus_V1.4.kicad_pcb from below]

Board: 2 copper layers, 100.0 x 60.0 mm, 276 parts (9 on the bottom side), 236 nets.

Other parts of the board:
C35, C125: 10uF; C_1206

Their connections:
GND: C35.1, C125.1; also elsewhere on the board
