maivananh111/PCB_GatewayPlus_V1.4/(commit log)

2023-02-28 Finish routing.
    [AUDIO.kicad_sch, ETH.kicad_sch, GatewayPlus_V1.4.kicad_pcb, GatewayPlus_V1.4.kicad_sch, LORA.kicad_sch, LTDC_LCD.kicad_sch, MCU.kicad_sch, MicroSD.kicad_sch]
2023-02-28 Fix some bug.
    [GatewayPlus_V1.4.kicad_pcb]
2023-03-02 Finished Board.
    [GatewayPlus_V1.4.kicad_pcb]
2023-03-02 Finish board.
    [ETH.kicad_sch, MicroSD.kicad_sch]
2023-03-05 Add power LED and some Silkscreen text.
    [ETH.kicad_sch, POWER.kicad_sch]
2023-04-14 Fix USB silkscreen name.
    [AUDIO.kicad_sch, ETH.kicad_sch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]
